SmartBioTech/Phenobottle_SBT/README.md

# CzechGlobe SmartBioTech Phenobottle

This project is originaly based on the Phenobottle from Harvey Bates. URL: https://github.com/HarveyBates/Phenobottle
