SmartBioTech/Phenobottle_SBT/Firmware/README.md

## Firmware  
Firmware for Teensy 3.6  

Code can be compiled and flashed from modified Arduino IDE  
https://www.arduino.cc/en/software  
https://www.pjrc.com/teensy/teensyduino.html
