SmartBioTech/Phenobottle_SBT/Printed_parts/Frame - Main_frame.stl

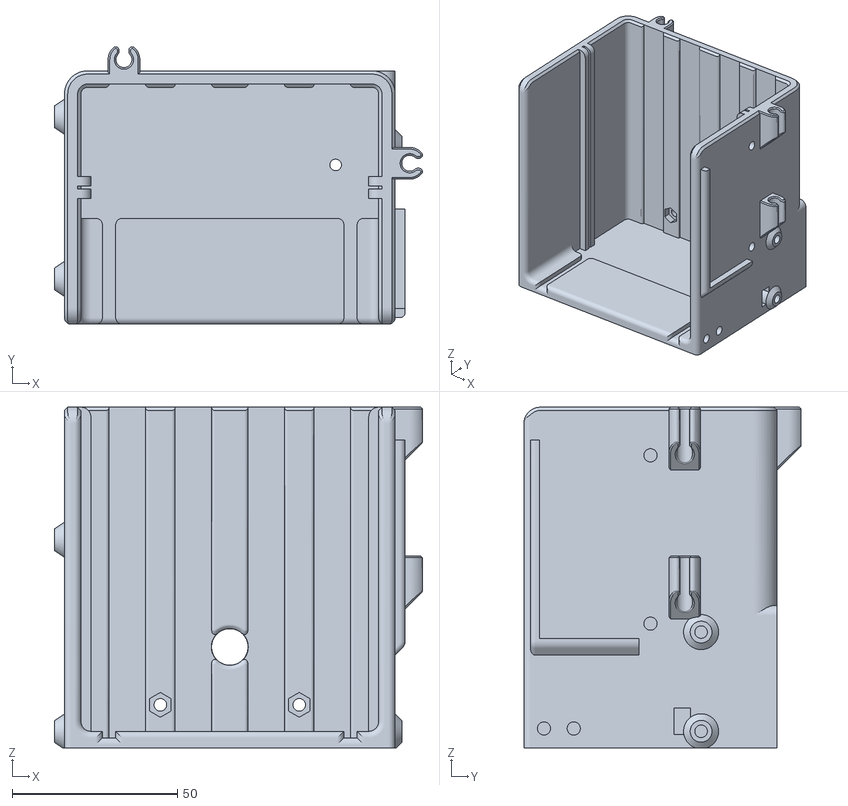
[picture p1: CAD file, 2022-07-25]
Printed_parts/Frame - Main_frame.stl
111.3 x 83.9 x 103.0
