SmartBioTech/Phenobottle_SBT/Printed_parts/Cuvette - Cap.stl

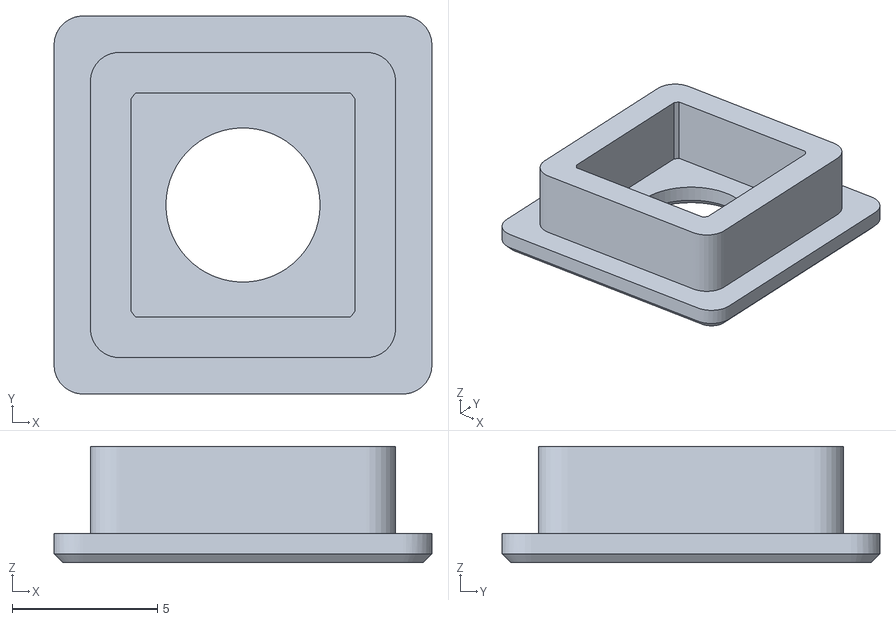
[picture p3: CAD file, 2022-07-25]
Printed_parts/Cuvette - Cap.stl
13.0 x 13.0 x 4.00
