SmartBioTech/Phenobottle_SBT/Printed_parts/Power_supply_case - Foots.stl

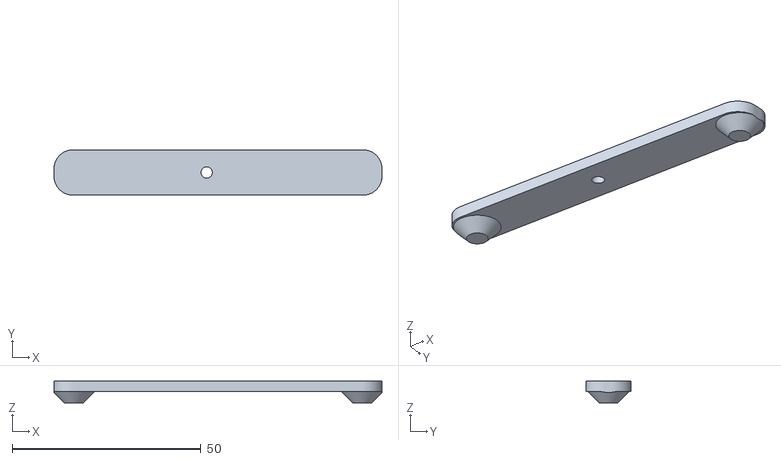
[picture p4: CAD file, 2022-07-25]
Printed_parts/Power_supply_case - Foots.stl
87.0 x 12.0 x 5.80
