SmartBioTech/Phenobottle_SBT/Printed_parts/Frame - Motor_fix.stl

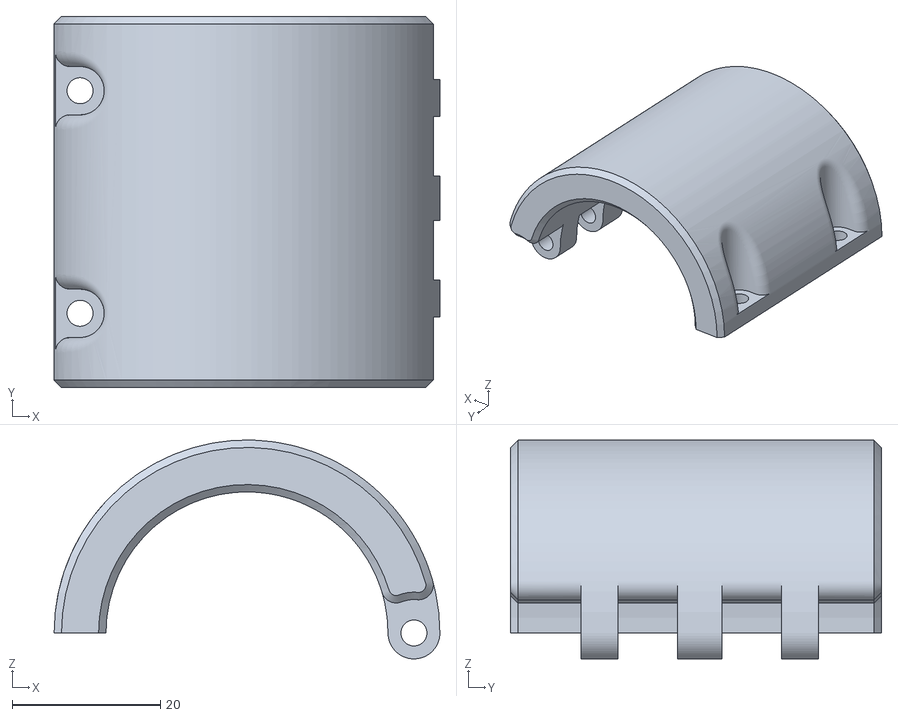
[picture p5: CAD file, 2022-07-25]
Printed_parts/Frame - Motor_fix.stl
52.0 x 50.0 x 29.5
