SmartBioTech/Phenobottle_SBT/Printed_parts/Frame - Fluorometer.stl

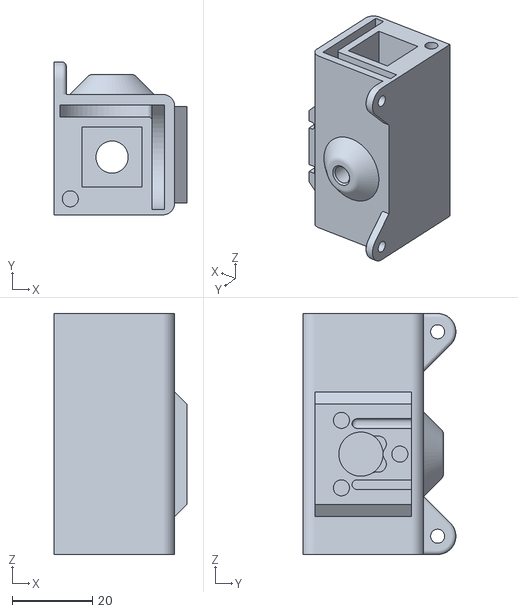
[picture p6: CAD file, 2022-07-25]
Printed_parts/Frame - Fluorometer.stl
33.0 x 38.0 x 60.0
