SmartBioTech/Phenobottle_SBT/Printed_parts/Mixing_system - Shaft_extension.stl

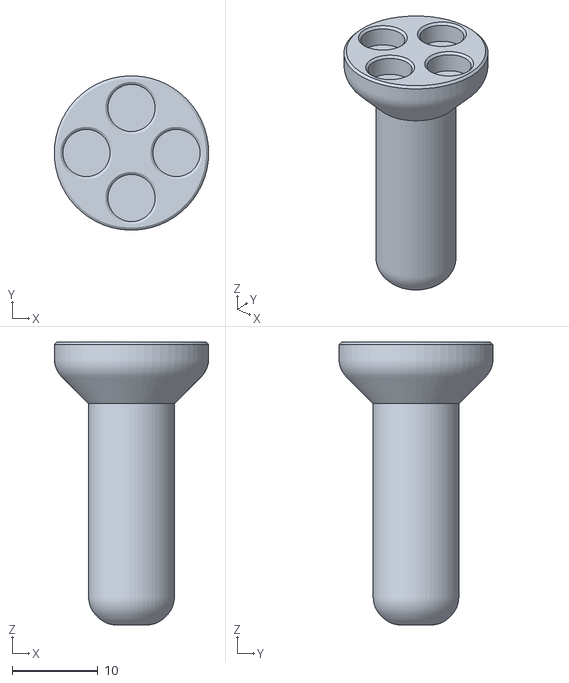
[picture p7: CAD file, 2022-07-25]
Printed_parts/Mixing_system - Shaft_extension.stl
18.0 x 18.0 x 33.0
