SmartBioTech/Phenobottle_SBT/Printed_parts/Frame - Front_LED.stl

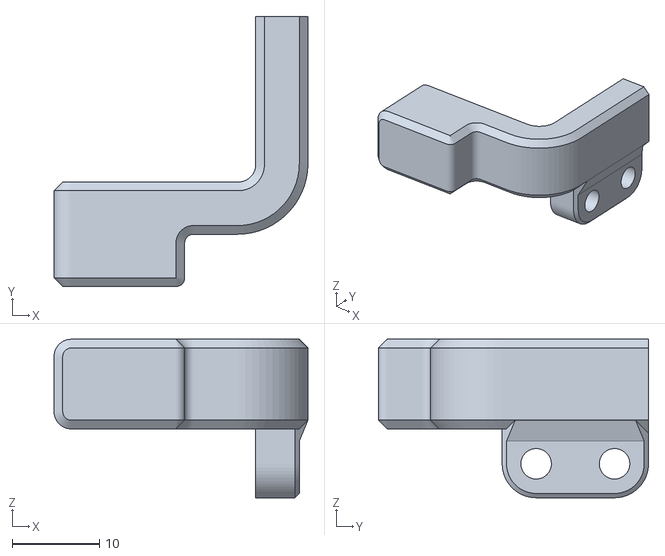
[picture p8: CAD file, 2022-07-25]
Printed_parts/Frame - Front_LED.stl
29.1 x 31.0 x 18.2
