SmartBioTech/Phenobottle_SBT/Printed_parts/Frame - Light_cover.stl

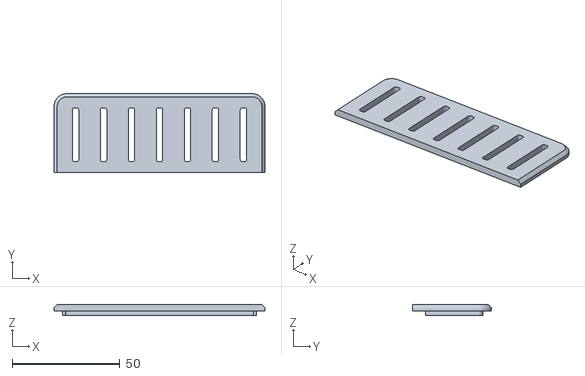
[picture p9: CAD file, 2022-07-25]
Printed_parts/Frame - Light_cover.stl
98.0 x 36.6 x 5.00
