SmartBioTech/Phenobottle_SBT/Printed_parts/Mixing_system - Stirrer.stl

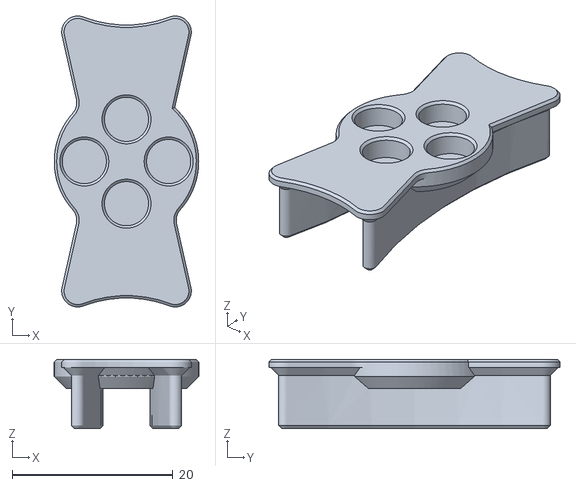
[picture p10: CAD file, 2022-07-25]
Printed_parts/Mixing_system - Stirrer.stl
18.0 x 36.2 x 8.60
