SmartBioTech/Phenobottle_SBT/Printed_parts/Frame - Bubbling_motor_fix.stl

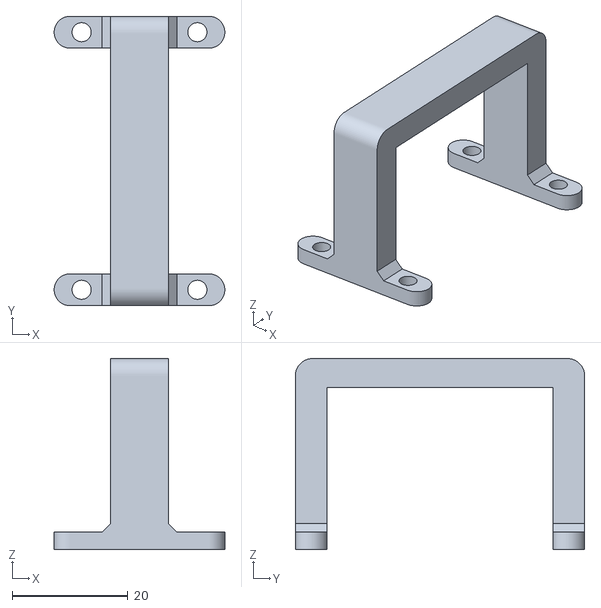
[picture p11: CAD file, 2022-07-25]
Printed_parts/Frame - Bubbling_motor_fix.stl
29.5 x 50.0 x 33.0
