SmartBioTech/Phenobottle_SBT/Printed_parts/Frame - Back_LED.stl

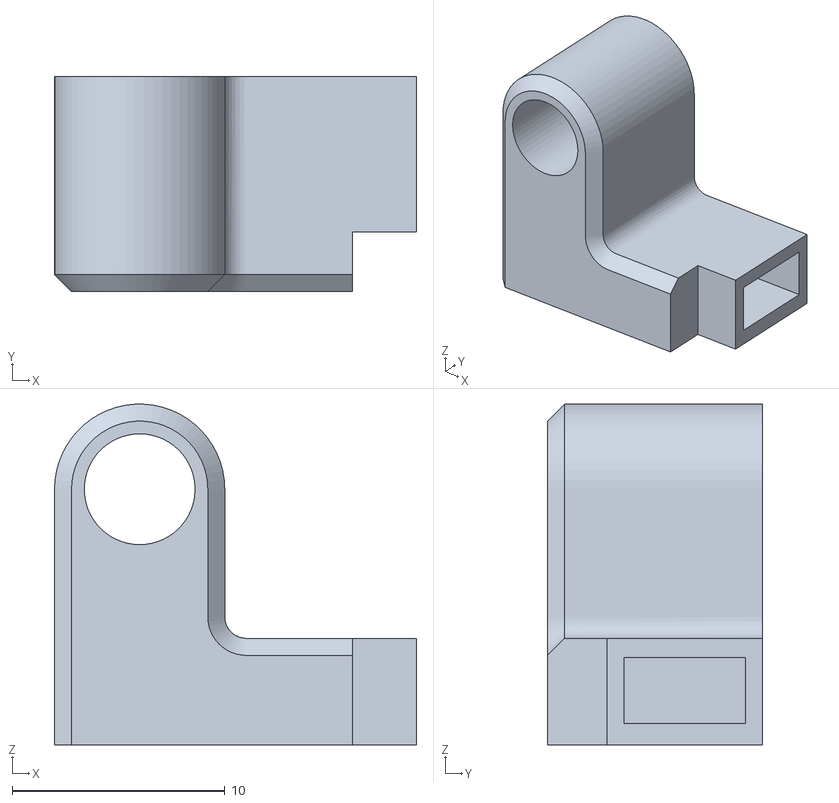
[picture p12: CAD file, 2022-07-25]
Printed_parts/Frame - Back_LED.stl
17.0 x 10.1 x 16.0
