SmartBioTech/Phenobottle_SBT/Printed_parts/Bottle - Cap.stl

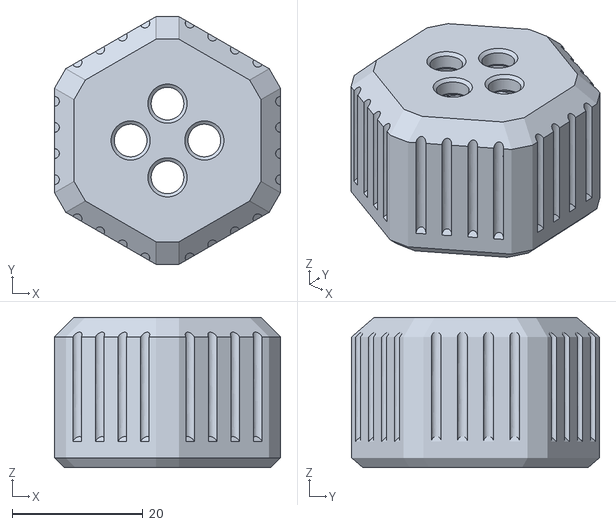
[picture p13: CAD file, 2022-07-25]
Printed_parts/Bottle - Cap.stl
34.6 x 38.0 x 23.0
