SmartBioTech/Phenobottle_SBT/Printed_parts/Frame - Motor_mount.stl

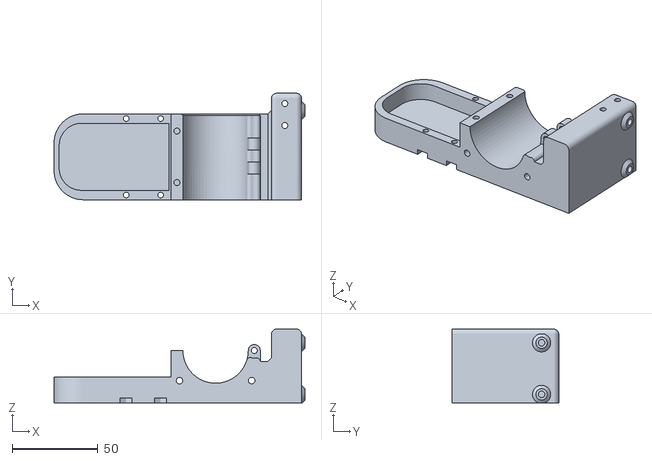
[picture p14: CAD file, 2022-07-25]
Printed_parts/Frame - Motor_mount.stl
146.0 x 62.0 x 43.0
