SmartBioTech/Phenobottle_SBT/Printed_parts/Power_supply_case - Case.stl

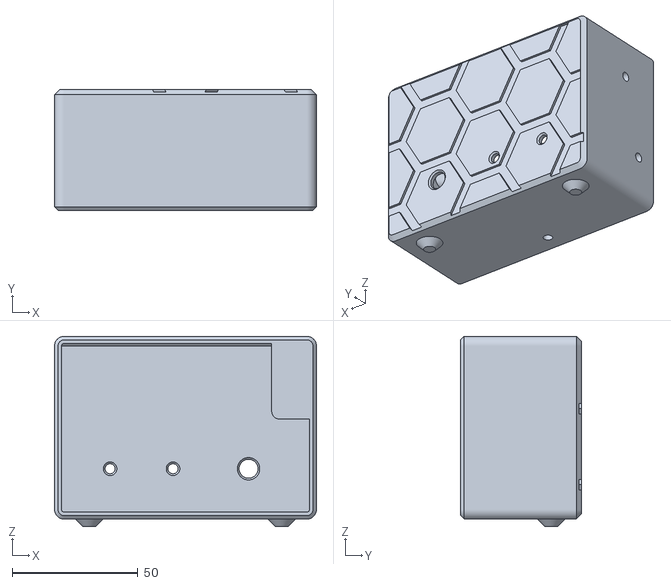
[picture p15: CAD file, 2022-07-25]
Printed_parts/Power_supply_case - Case.stl
104.1 x 48.0 x 75.6
