SmartBioTech/Phenobottle_SBT/Printed_parts/LED_cover.stl

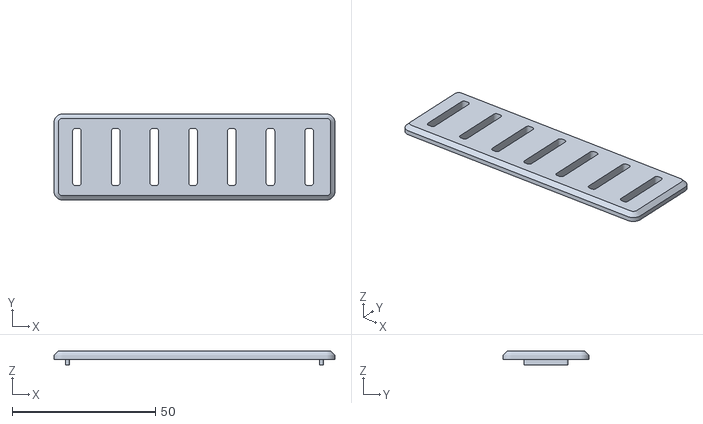
[picture p16: CAD file, 2022-07-25]
Printed_parts/LED_cover.stl
98.0 x 30.0 x 5.00
