SmartBioTech/Phenobottle_SBT/Printed_parts/Frame - Fluorometer-Cap.stl

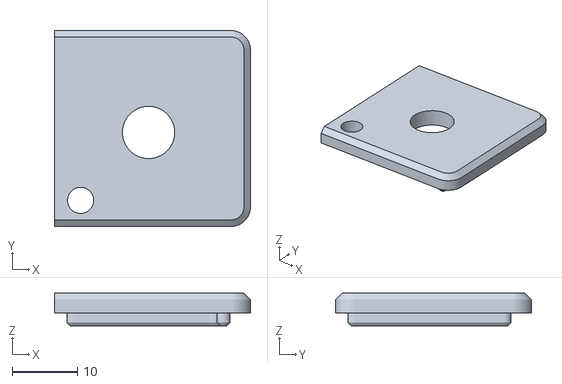
[picture p17: CAD file, 2022-07-25]
Printed_parts/Frame - Fluorometer-Cap.stl
30.0 x 30.0 x 5.00
