SmartBioTech/Phenobottle_SBT/PCB/Phenobottle.kicad_pcb

## KiCad design PCB/Phenobottle.kicad_pcb (2022-07-25)

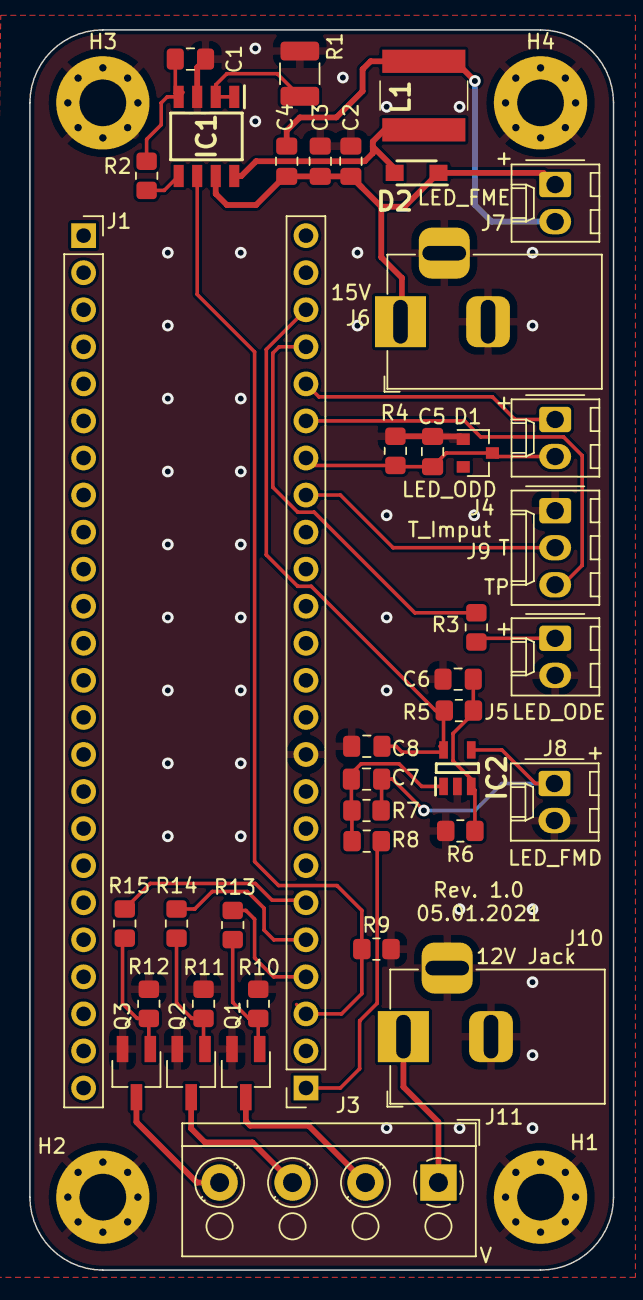
[picture p18: board Phenobottle.kicad_pcb from above]

Board: 2 copper layers, 40.0 x 85.0 mm, 45 parts (0 on the bottom side), 29 nets.

Parts:
C1: 1uF; C_0805_2012Metric_Pad1.18x1.45mm_HandSolder
C2: 4.7uF; C_0805_2012Metric_Pad1.18x1.45mm_HandSolder
C3: 100nF; C_0805_2012Metric_Pad1.18x1.45mm_HandSolder
C4: DNP; C_0805_2012Metric_Pad1.18x1.45mm_HandSolder
C5: 100nf; C_0805_2012Metric_Pad1.18x1.45mm_HandSolder
C6, C8: 100n; C_0805_2012Metric_Pad1.18x1.45mm_HandSolder
C7: Cf; C_0805_2012Metric_Pad1.18x1.45mm_HandSolder
D1: BZX84C3V6LT1G; D_SOT-23_ANK
D2: MBR140SFT3G; SODFL3616X98N
H1, H2, H3, H4: MountingHole_Pad; MountingHole_3.2mm_M3_Pad_Via
IC1: NCL30160DR2G; SOIC127P600X175-8N
IC2: OPA320AIDBVR; SOT95P280X145-5N
J1, J3: Conn_01x24_Female; PinSocket_1x24_P2.54mm_Vertical
J4: LED_ODD; Molex_KK-254_AE-6410-02A_1x02_P2.54mm_Vertical
J5: LED_ODE; Molex_KK-254_AE-6410-02A_1x02_P2.54mm_Vertical
J6: 15V; BarrelJack_Horizontal
J7: LED_FME; Molex_KK-254_AE-6410-02A_1x02_P2.54mm_Vertical
J8: LED_FMD; Molex_KK-254_AE-6410-02A_1x02_P2.54mm_Vertical
J9: T_Imput; Molex_KK-254_AE-6410-03A_1x03_P2.54mm_Vertical
J10: 12V Jack; BarrelJack_Horizontal
J11: RGB; TerminalBlock_RND_205-00003_1x04_P5.00mm_Horizontal
L1: 15uH@0.19R; NR6045T150M
Q1, Q2, Q3: DMN1019USN; SC-59_Handsoldering
R1: 0.287; R_1210_3225Metric_Pad1.30x2.65mm_HandSolder
R2: 24K; R_0805_2012Metric_Pad1.20x1.40mm_HandSolder
R3, R6: 220; R_0805_2012Metric_Pad1.20x1.40mm_HandSolder
R4: R; R_0805_2012Metric_Pad1.20x1.40mm_HandSolder
R5: 20K; R_0805_2012Metric_Pad1.20x1.40mm_HandSolder
R7: 4.7M; R_0805_2012Metric_Pad1.20x1.40mm_HandSolder
R8: 47; R_0805_2012Metric_Pad1.20x1.40mm_HandSolder
R9: 4k7; R_0805_2012Metric_Pad1.20x1.40mm_HandSolder
R10: 10K; R_0805_2012Metric_Pad1.20x1.40mm_HandSolder
R11, R12: 10k; R_0805_2012Metric_Pad1.20x1.40mm_HandSolder
R13, R14, R15: 165R; R_0805_2012Metric_Pad1.20x1.40mm_HandSolder

Connections:
/1a1: C2.1, C3.1, C4.2, D2.1, IC1.7 (VIN), J6.1, J7.1
/1a2: D2.2, IC1.8 (LX), L1.1
/1a3: C4.1, J7.2, L1.2
/LED1: J11.2, Q1.3 (D)
/LED2: J11.3, Q2.3 (D)
/LED3: J11.4, Q3.3 (D)
/LEDV: J10.1, J11.1
Brightness: IC1.6 (~DIM~/ENABLE), J3.3, R9.1
Fluro: J3.1, R8.2
GND: C1.2, C2.2, C3.2, C5.1, C6.2, C8.2, D1.2 (A), H1.1, H2.1, H3.1, H4.1, IC1.3 (GND), IC2.2 (V-), J3.10, J5.2, J6.2, J6.3, J8.2, J9.1, J10.2, J10.3, Q1.2 (S), Q2.2 (S), Q3.2 (S), R1.2, R4.2, R6.1, R9.2, R10.2, R11.2, R12.2
LED_B: J3.4, R13.1
LED_G: J3.5, R14.1
LED_R: J3.6, R15.1
unnamed: C1.1, IC1.4 (VCC), R2.1
unnamed: C6.1, IC2.3 (+IN), R5.1, R6.2
unnamed: C7.1, IC2.4 (-IN), J8.1, R7.1
unnamed: C7.2, IC2.1 (OUT), R7.2, R8.1
unnamed: IC1.1 (CS_1), IC1.2 (CS_2), R1.1
unnamed: IC1.5 (ROT), R2.2
unnamed: J5.1, R3.2
unnamed: Q1.1 (G), R10.1, R13.2
unnamed: Q2.1 (G), R11.1, R14.2
unnamed: Q3.1 (G), R12.1, R15.2
ODdPower: J3.20, J4.1
ODdetect: C5.2, D1.1 (K), J3.18, J4.2, R4.1
ODePower: J3.21, R3.1
TempPower: J3.19, J9.3
Temperature: J3.17, J9.2
VCC: C8.1, IC2.5 (V+), J3.22, R5.2
